CascoLogix/arduino_pro_mini_mikrobus/Hardware/EDA/Rendered_Pics/Arduino_Pro_Mini_mikroBUS2_2xAA.png

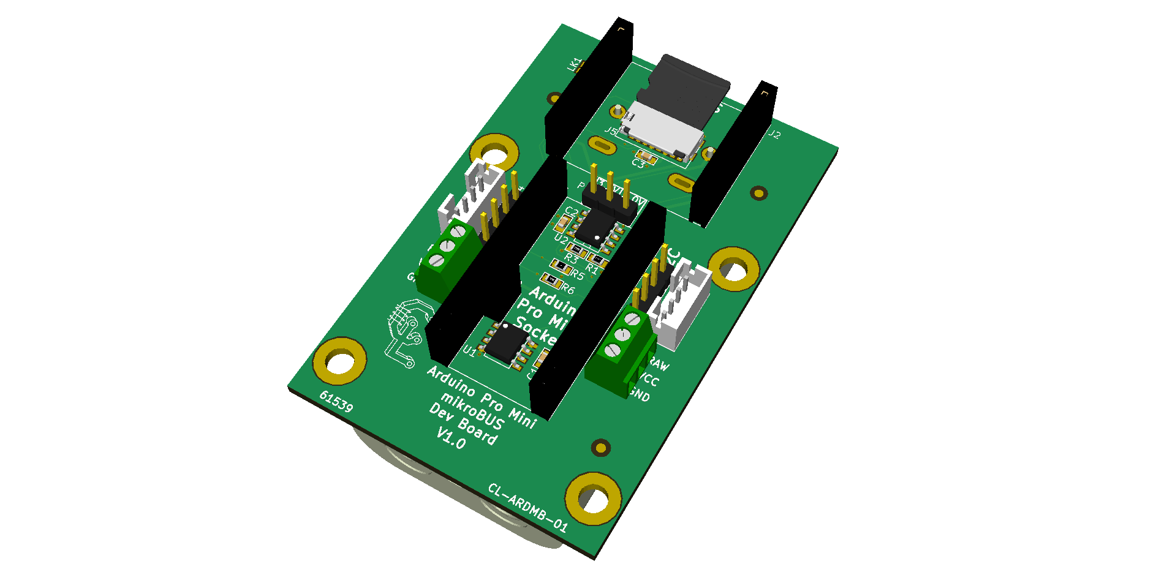
Hardware/EDA/Rendered_Pics/Arduino_Pro_Mini_mikroBUS2_2xAA.png
