CascoLogix/arduino_pro_mini_mikrobus/Hardware/EDA/Rendered_Pics/Arduino_Pro_Mini_mikroBUS10_9V.png

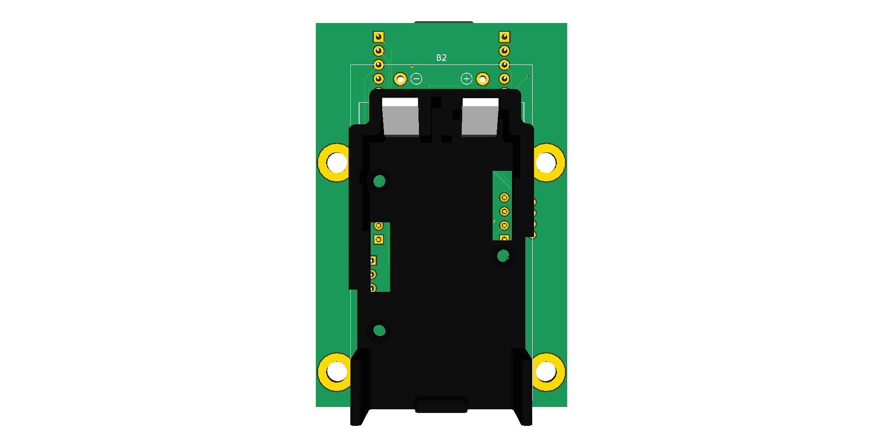
Hardware/EDA/Rendered_Pics/Arduino_Pro_Mini_mikroBUS10_9V.png
