CascoLogix/arduino_pro_mini_mikrobus/Hardware/EDA/PCB_Assembly/Arduino_Pro_Mini_mikroBUS_BOM.ods

Reference | Quantity | Value | Footprint | Datasheet | Vendor | Vendor P/N | Vendor Price | Manufacturer | Manufacturer P/N | Subtotal | Casco Logix P/N | Modified Qty | Subtotal
B1 | 1 | 9V | Battery:BC9VPC |  | Digi-Key | BC9VPC-ND | $1.75 | Memory Protection Devices | BC9VPC | $1.75 | 61548 | 0 | $0.00
B2 | 1 | 2xAA | Battery:Keystone_2462_2AA |  | Digi-Key | 36-2462-ND | $1.51 | Keystone | 2462 | $1.51 | 61547 | 0 | $0.00
C1 C2 C3 | 3 | 1uF | Passive:0603 |  | Digi-Key | 1276-1946-1-ND | $0.10 | Samsung | CL10B105KP8NNNC | $0.30 | 61401 | 3 | $0.30
G1 | 1 | DNP | DNP |  |  |  |  |  |  | $0.00 |  | 0 | $0.00
J1 J2 | 2 | HEADER_F_2.54MM_1R8P_ST_AU_PTH | Header:HEADER_F_2.54MM_1R8P_ST_AU_PTH |  | Digi-Key | S7008-ND | $0.65 | Sullins Connector Solutions | PPTC101LFBN-RC | $1.30 | 61418 | 2 | $1.30
J3 J4 | 2 | HEADER_F_2.54MM_1R12P_ST_AU_PTH | Header:HEADER_F_2.54MM_1R12P_ST_AU_PTH |  | Digi-Key | S7012-ND | $0.91 | Sullins Connector Solutions | PPTC141LFBN-RC | $1.82 | 61544 | 2 | $1.82
J5 | 1 | Molex_0475710001 | Connector:Molex_0475710001 |  | Digi-Key | WM9731CT-ND | $0.98 | Molex | ‘0475710001 | $0.98 | 61546 | 1 | $0.98
J6 | 1 | HEADER_F_2.54MM_1R2P_ST_AU_PTH | Header:HEADER_F_2.54MM_1R2P_ST_SN_PTH |  | Digi-Key | S7000-ND | $0.32 | Sullins Connector Solutions | PPTC021LFBN-RC | $0.32 | 61550 | 1 | $0.32
LK1 | 1 | DNP | DNP |  |  |  | $0.00 |  |  | $0.00 |  | 0 | $0.00
M1 M2 M3 | 3 | DNP | DNP |  |  |  | $0.00 |  |  | $0.00 |  | 0 | $0.00
MH1 MH2 MH3 MH4 | 4 | DNP | DNP |  |  |  | $0.00 |  |  | $0.00 |  | 0 | $0.00
P1 | 1 | HEADER_M_2.54MM_1R3P_ST_AU_PTH | Header:HEADER_M_2.54MM_1R3P_ST_AU_PTH |  | Digi-Key | S1012EC-03-ND | $0.14 | Sullins Connector Solutions | PREC003SAAN-RC | $0.14 | 61490 | 0 | $0.00
P2 P3 P4 P5 | 2 | HEADER_M_2.54MM_1R4P_ST_AU_PTH | Header:HEADER_M_2.54MM_1R4P_ST_AU_PTH |  | Digi-Key | S1012EC-04-ND | $0.15 | Sullins Connector Solutions | PREC004SAAN-RC | $0.30 | 61492 | 0 | $0.00
P2 P3 P4 P5 | 2 | HEADER_M_2.54MM_1R4P_ST_AU_PTH | Header:PH_2.0_PTH |  | Digi-Key | 455-1706-ND | $0.24 | JST | B4B-PH-K-S(LF)(SN) | $0.48 | 61416 | 0 | $0.00
R1 R2 R3 R4 R5 R6 | 6 | 4.7k | Passive:R0603 |  | Digi-Key | 311-4.7KGRCT-ND | $0.10 | Yageo | RC0603JR-074K7L | $0.60 | 61517 | 6 | $0.60
TB1 TB2 | 2 | OSTVN_1x3 | Terminal_Block:TB_100MIL_1R3P_PTH |  | Digi-Key | ED10562-ND | $1.03 | On Shore Technology | OSTVN03A150 | $2.06 | 61545 | 0 | $0.00
U1 | 1 | FL127 | Active:SO-8 |  | Digi-Key | W25Q16JVSSIQ-ND | $0.60 | Winbond | W25Q16JVSSIQ | $0.60 | 61449 | 1 | $0.60
U2 | 1 | MCP7940M-I/SN | Active:SO-8 |  | Digi-Key | MCP7940M-I/SN-ND | $0.61 | Microchip | MCP7940M-I/SN | $0.61 | 61549 | 1 | $0.61
 | 1 | DNP | DNP |  | Digi-Key | 3M9580-ND |  | 3M | 969102-0000-DA |  | 61503 | 1 | $0.00
PCB | 1 | DNP | DNP |  | EasyEDA | 61539 | $3.28 | EasyEDA | 61539 | $3.28 | 61539 | 1 | $3.28
 |  |  |  |  |  |  |  |  |  | $16.05 |  |  | $9.81
