CascoLogix/arduino_pro_mini_mikrobus/Hardware/EDA/Drawing/Arduino_Pro_Mini_mikroBUS.pdf

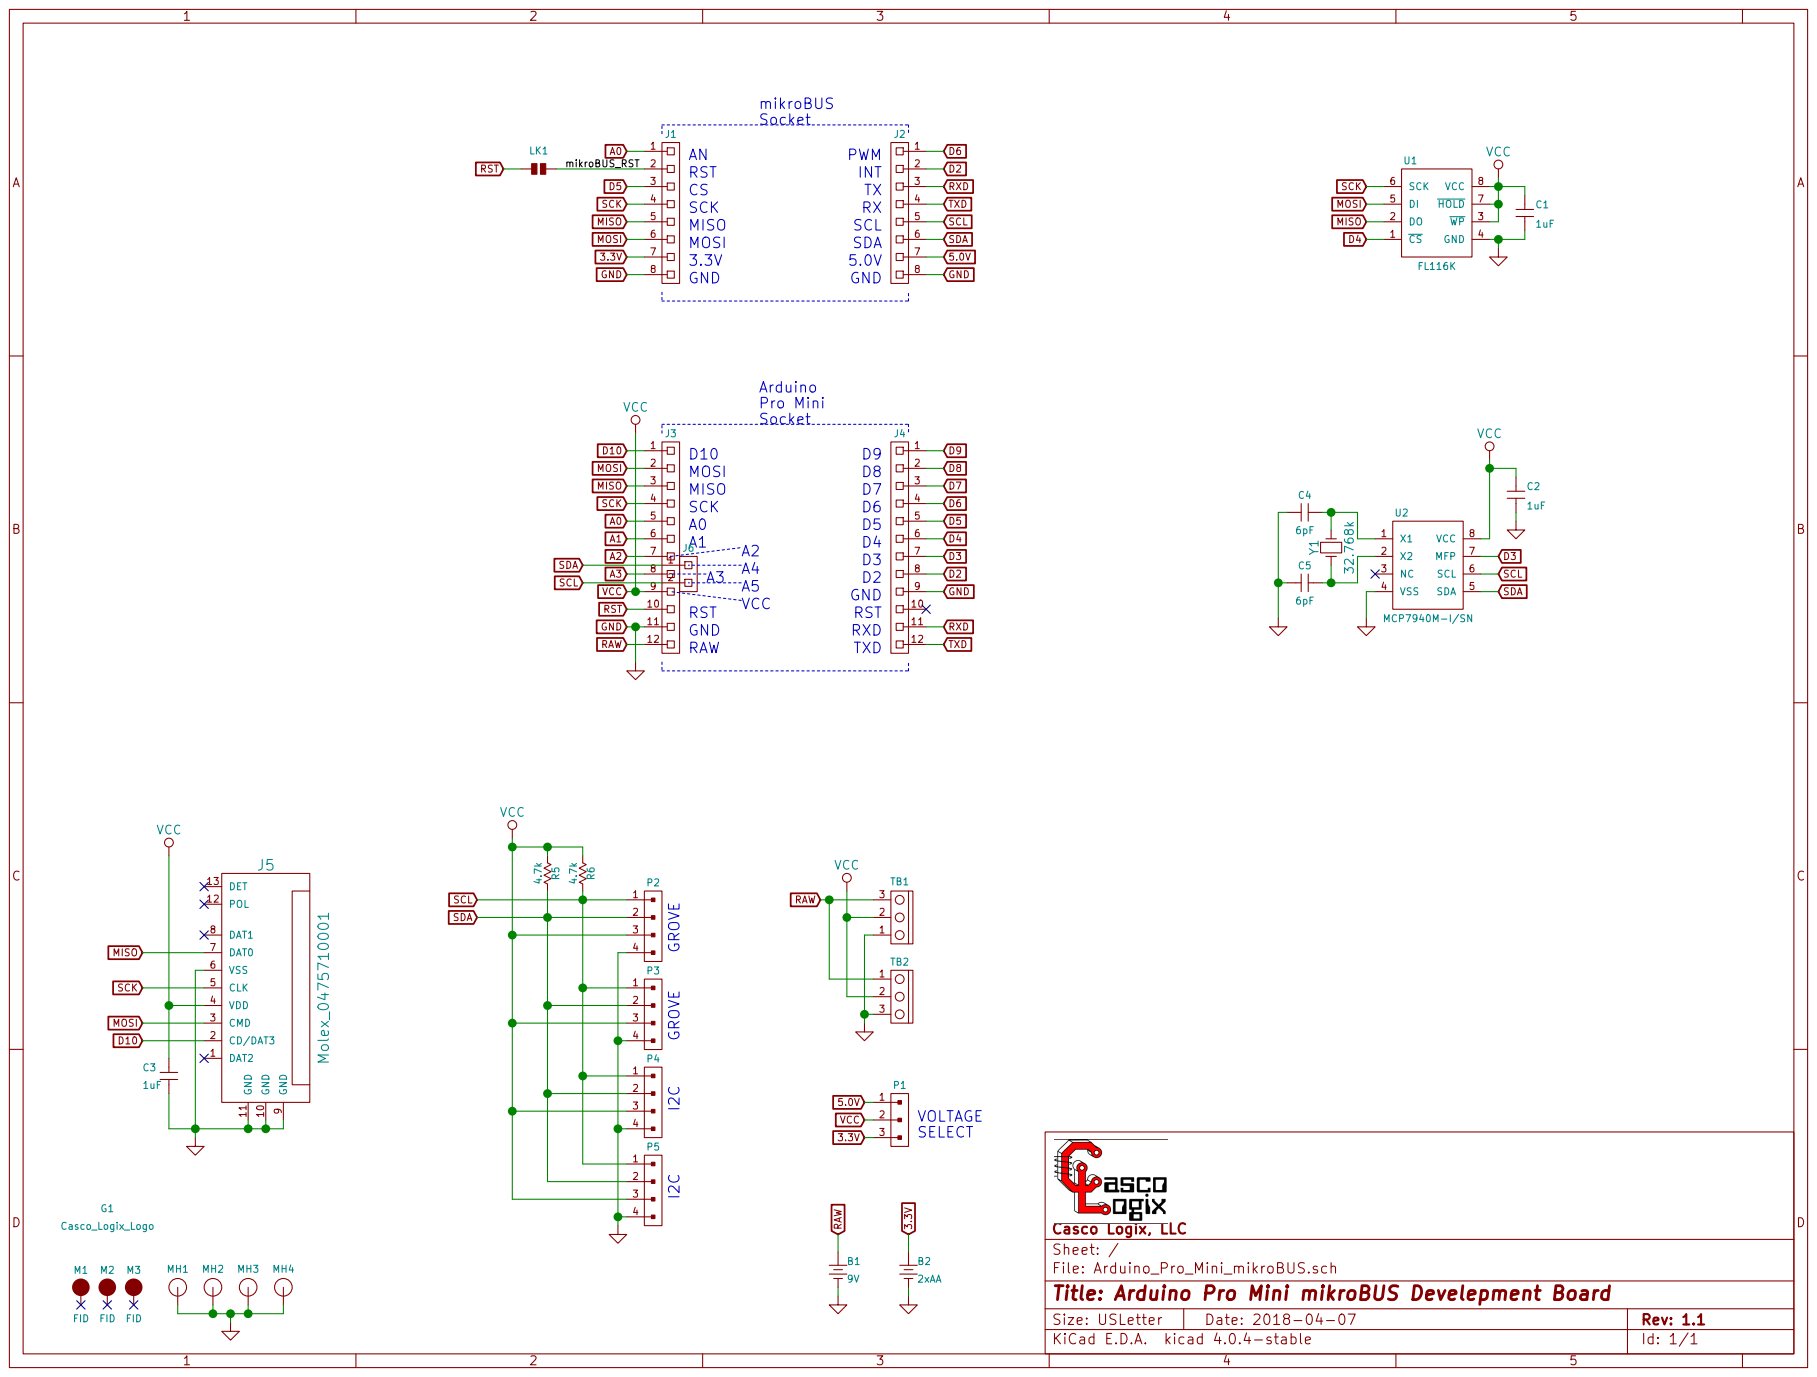
[picture p5: page 1]

Socket Arduino Pro Mini Socket RAW

9 GND 10 GND 11 POL 12 DET 13 J5 Molex_0475710001

File: Arduino_Pro_Mini_mikroBUS.sch Sheet: / Casco Logix, LLC

Id: 1/1 Title: Arduino Pro Mini mikroBUS Develepment Board
