CascoLogix/arduino_pro_mini_mikrobus/Hardware/EDA/Arduino_Pro_Mini_mikroBUS.kicad_pcb

## KiCad design Hardware/EDA/Arduino_Pro_Mini_mikroBUS.kicad_pcb (2018-04-07)

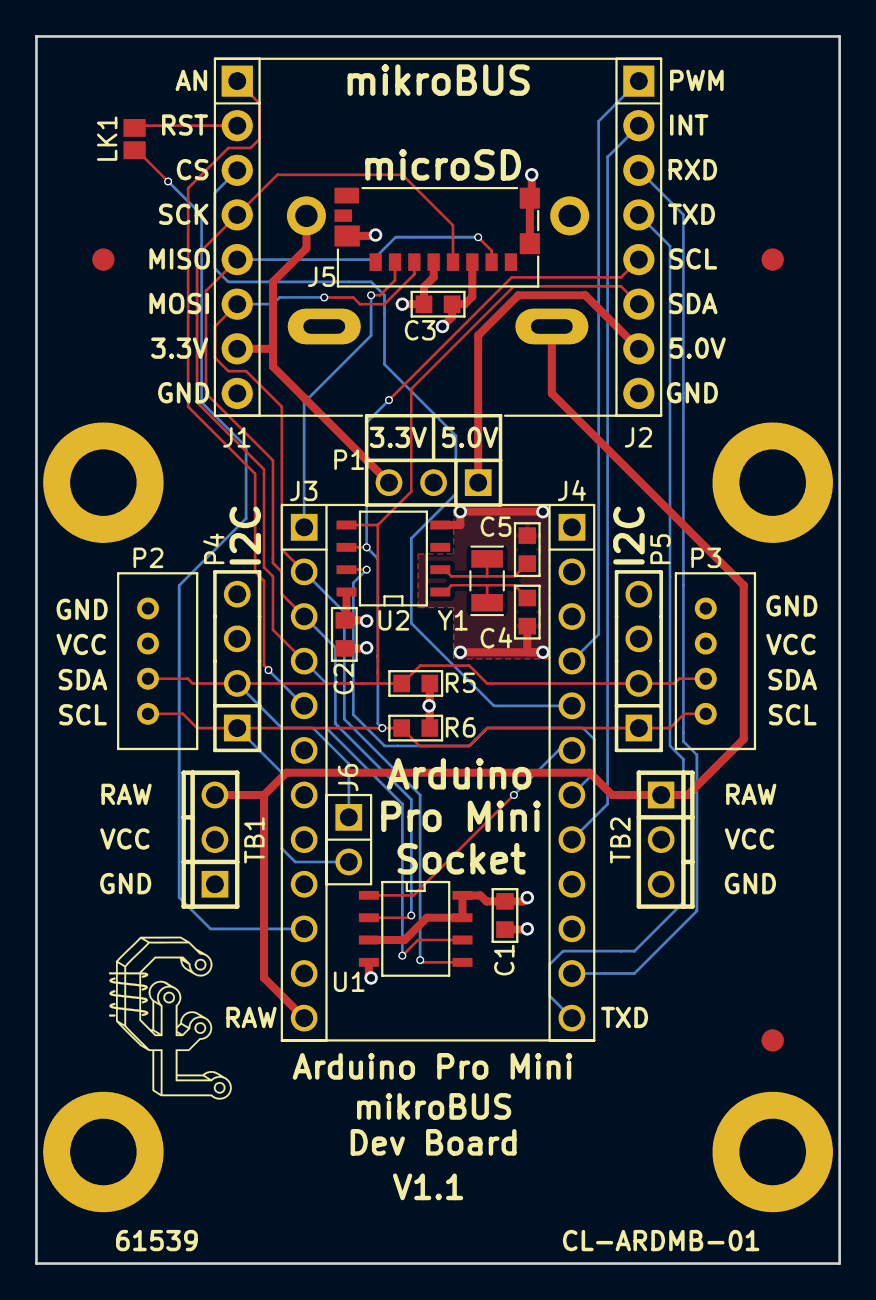
[picture p6: board Arduino_Pro_Mini_mikroBUS.kicad_pcb from above]

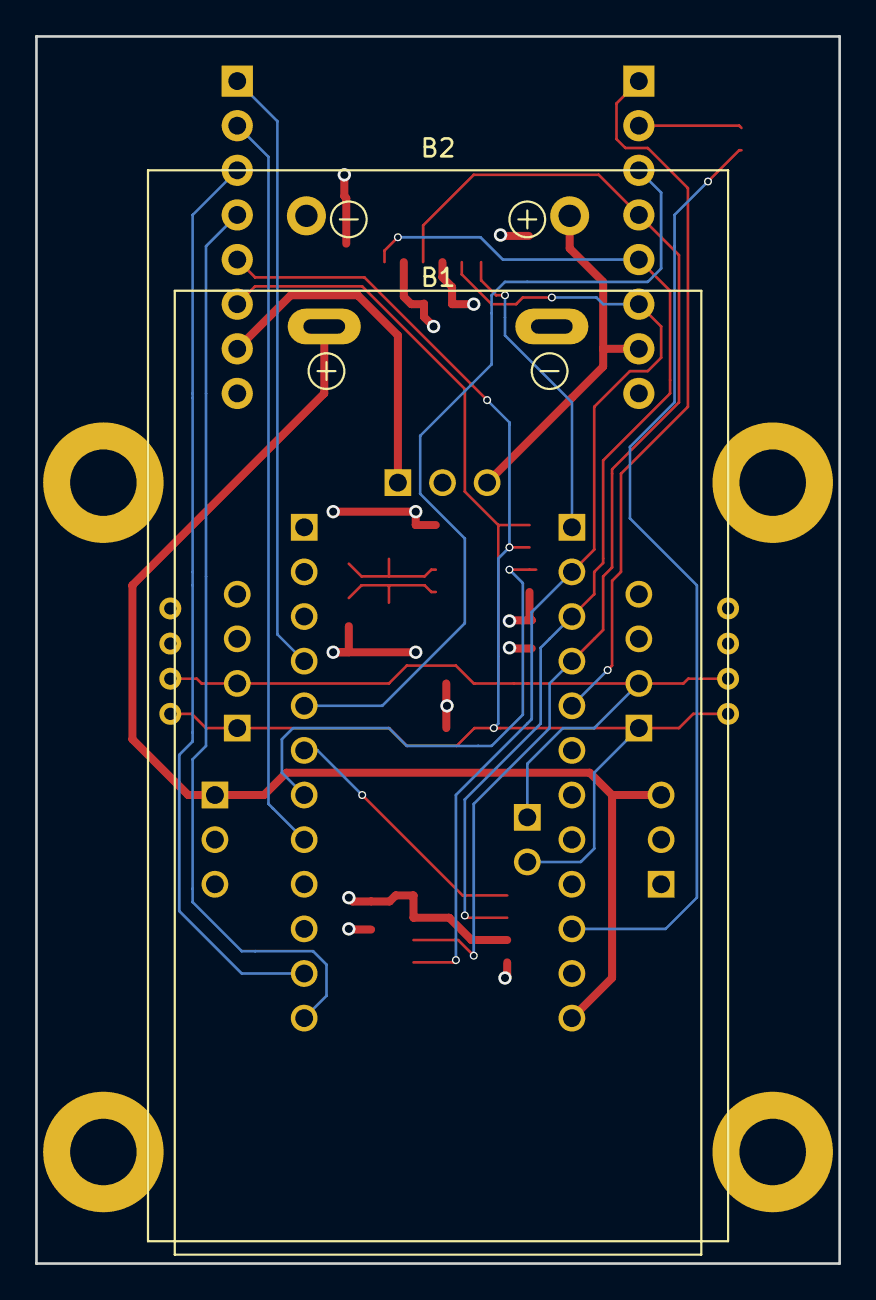
[picture p7: board Arduino_Pro_Mini_mikroBUS.kicad_pcb from below]

Board: 4 copper layers, 45.7 x 69.8 mm, 34 parts (2 on the bottom side), 23 nets.

Parts:
B1: 9V; BC9VPC
B2: 2xAA; Keystone_2462_2AA
C1, C2, C3: 1uF; 0603
C4, C5: 6pF; 0603
G1: Casco_Logix_Logo; Casco_Logix_Logo_7x7MM
J1, J2: HEADER_F_2.54MM_1R8P_ST_AU_PTH
J3, J4: HEADER_F_2.54MM_1R12P_ST_AU_PTH; HEADER_F_2.54MM_1R12P_ST_SN_PTH
J5: Molex_0475710001
J6: HEADER_F_2.54MM_1R2P_ST_AU_PTH; HEADER_F_2.54MM_1R2P_ST_SN_PTH
LK1: SOLDER_LINK_NO
M1, M2, M3: FID; FIDUCIAL
MH1, MH2, MH3, MH4: MTG_HOLE; MH_#6
P1: HEADER_M_2.54MM_1R3P_ST_AU_PTH
P2, P3: HEADER_M_2.54MM_1R4P_ST_AU_PTH; PH_2.0_PTH
P4, P5: HEADER_M_2.54MM_1R4P_ST_AU_PTH
R5, R6: 4.7k; R0603
TB1, TB2: OSTVN_1x3; TB_100MIL_1R3P_PTH
U1: FL116K; SO-8
U2: MCP7940M-I/SN; SO-8
Y1: 32.768k; XTAL_3.2MM_1.5MM_SMT_ALT

Connections:
3.3V: B2.1, J1.7, P1.3
5.0V: J2.7, P1.1
/mikroBUS_RST: J1.2, LK1.2
A0: J1.1, J3.5
D2: J2.2, J4.8
D3: J4.7, U2.7
D4: J4.6, U1.1
D5: J1.3, J4.5
D6: J2.1, J4.4
D10: J3.1, J5.2
GND: B1.2, B2.2, C1.2, C2.2, C3.2, C4.2, C5.2, J1.8, J2.8, J3.11, J4.9, J5.6, J5.9, J5.10, J5.11, MH1.~, MH2.~, MH3.~, MH4.~, P2.4, P3.4, P4.4, P5.4, TB1.1, TB2.3, U1.4, U2.4
MISO: J1.5, J3.3, J5.7, U1.2
MOSI: J1.6, J3.2, J5.3, U1.5
unnamed: C4.1, U2.1, Y1.2
unnamed: C5.1, U2.2, Y1.1
RAW: B1.1, J3.12, TB1.3, TB2.1
RST: J3.10, LK1.1
RXD: J2.3, J4.11
SCK: J1.4, J3.4, J5.5, U1.6
SCL: J2.5, J6.2, P2.1, P3.1, P4.1, P5.1, R6.2, U2.6
SDA: J2.6, J6.1, P2.2, P3.2, P4.2, P5.2, R5.2, U2.5
TXD: J2.4, J4.12
VCC: C1.1, C2.1, C3.1, J3.9, J5.4, P1.2, P2.3, P3.3, P4.3, P5.3, R5.1, R6.1, TB1.2, TB2.2, U1.3, U1.7, U1.8, U2.8
