CascoLogix/arduino_pro_mini_mikrobus/(threads)

Thread 1 (2018-03-30):

Crystal Missing from RTC

CascoLogix, 2018-03-30:
Select resistors mistakely placed where RTC 32.768kHz crystal should have been.

CascoLogix, 2018-04-07:
Added crystal and caps for RTC.
https://github.com/CascoLogix/arduino_pro_mini_mikrobus/commit/56724267e5ea01575be59fef9f3b4378eb278898

Closed 2018-04-07.

Thread 2 (2018-03-30):

3V Battery Holder Footprint Pins Swapped

CascoLogix, 2018-03-30:
3V battery holder footprint has pins swapped so polarity is reversed.  This should be corrected in the Casco Logix KiCAD component library, then update the layout.

CascoLogix, 2018-04-07:
Resolved error in KiCAD Library here:
[https://github.com/CascoLogix/KiCAD_Libraries/commit/263f8f1407974923df24015b3ebbb44121946b9c](url)

Issue resolution is pending layout corrections to PCB.

CascoLogix, 2018-04-07:
Layout corrections completed:
https://github.com/CascoLogix/arduino_pro_mini_mikrobus/commit/56724267e5ea01575be59fef9f3b4378eb278898

Closed 2018-04-07.

Thread 3 (2018-03-30):

9V Battery Holder Footprint Pins Swapped

CascoLogix, 2018-03-30:
9V battery holder footprint has pins swapped so polarity is reversed.  This should be corrected in the Casco Logix KiCAD component library, then update the layout.

CascoLogix, 2018-04-07:
Resolved error in KiCAD Library here:
[https://github.com/CascoLogix/KiCAD_Libraries/commit/263f8f1407974923df24015b3ebbb44121946b9c](url)

Issue resolution is pending layout corrections to PCB.

CascoLogix, 2018-04-07:
Layout corrections completed:
https://github.com/CascoLogix/arduino_pro_mini_mikrobus/commit/56724267e5ea01575be59fef9f3b4378eb278898

Closed 2018-04-07.
