CascoLogix/arduino_pro_mini_mikrobus/(commit log)

2017-12-27 Initial commit.
    [Arduino_Pro_Mini_mikroBUS.kicad_pcb, Arduino_Pro_Mini_mikroBUS.sch]
2017-12-27 Changed uSD CS pin to D10. Connected mikroBUS PWM pin to D6. Altered front silkscreen. Generated PDF schematic and Gerbers.
    [Arduino_Pro_Mini_mikroBUS.kicad_pcb, Arduino_Pro_Mini_mikroBUS.sch]
2017-12-28 Updated silkscreen artwork. Generated new gerbers and BOM.
    [Arduino_Pro_Mini_mikroBUS-Grouped-Comma-Delimited-BOM.csv, Arduino_Pro_Mini_mikroBUS.kicad_pcb]
2017-12-28 Corrected part# on silkscreen artwork.
    [Arduino_Pro_Mini_mikroBUS.kicad_pcb]
2017-12-29 Added PCB render image.
2017-12-29 Updated bad 3D model links.
    [Arduino_Pro_Mini_mikroBUS.kicad_pcb]
2018-01-03 Removed barrel jack connector due to interference with Arduino Pro Mini. Updated schematic, layout and generated new gerbers. Added BOM file.
    [Arduino_Pro_Mini_mikroBUS-Grouped-Comma-Delimited-BOM.csv, Arduino_Pro_Mini_mikroBUS.kicad_pcb, Arduino_Pro_Mini_mikroBUS.sch, Arduino_Pro_Mini_mikroBUS_BOM.ods]
2018-01-05 Move location of P1 down slightly to allow more room for mikroBUS module PCB.
    [Arduino_Pro_Mini_mikroBUS.kicad_pcb]
2018-01-05 Updated PCB render images.
2018-01-06 Changed PCB outline/size to accomodate mounting holes, but still fit in enclosure. Regenerated Gerbers and PCB render images.
    [Arduino_Pro_Mini_mikroBUS.kicad_pcb]
2018-01-14 Found error in BOM as exported from schematic. Grove connectors had wrong footprint assigned. Corrected mistake in schematic and updated netlist and BOM.
    [Arduino_Pro_Mini_mikroBUS.sch, Arduino_Pro_Mini_mikroBUS_BOM.ods]
2018-02-12 Initial updates based on first build and testing. Final updates to be pushed in subsequent commit(s).
    [Arduino_Pro_Mini_mikroBUS.kicad_pcb, Arduino_Pro_Mini_mikroBUS.sch]
2018-02-17 Few more updates.
    [Arduino_Pro_Mini_mikroBUS.kicad_pcb]
2018-04-07 Added layout for RTC crystal and caps. Re-routed several traces as-needed. Updated RTC and crystal component parameters in schematic and regenerated netlist. Gerbers generated - need final review bef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
    [Arduino_Pro_Mini_mikroBUS.kicad_pcb, Arduino_Pro_Mini_mikroBUS.sch]
2018-04-07 Updated date in schematic and PCB title block. Regenerated PDF schematic. Verified gerbers.
    [Arduino_Pro_Mini_mikroBUS.kicad_pcb, Arduino_Pro_Mini_mikroBUS.sch]
2018-05-06 Updated BOM to include 32.768 Xtal.
    [Arduino_Pro_Mini_mikroBUS_BOM.ods]
